Luthor2k/baudotty/scrap/alive.png

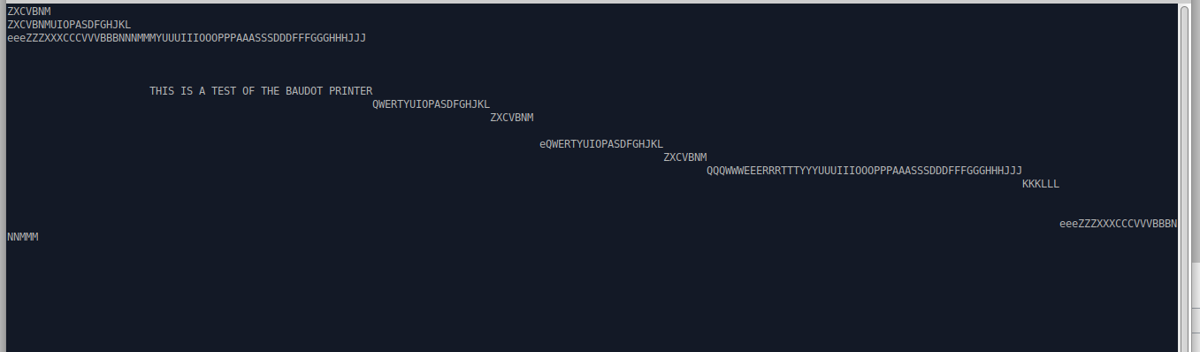
scrap/alive.png
