Luthor2k/baudotty/scrap/baudot2.png

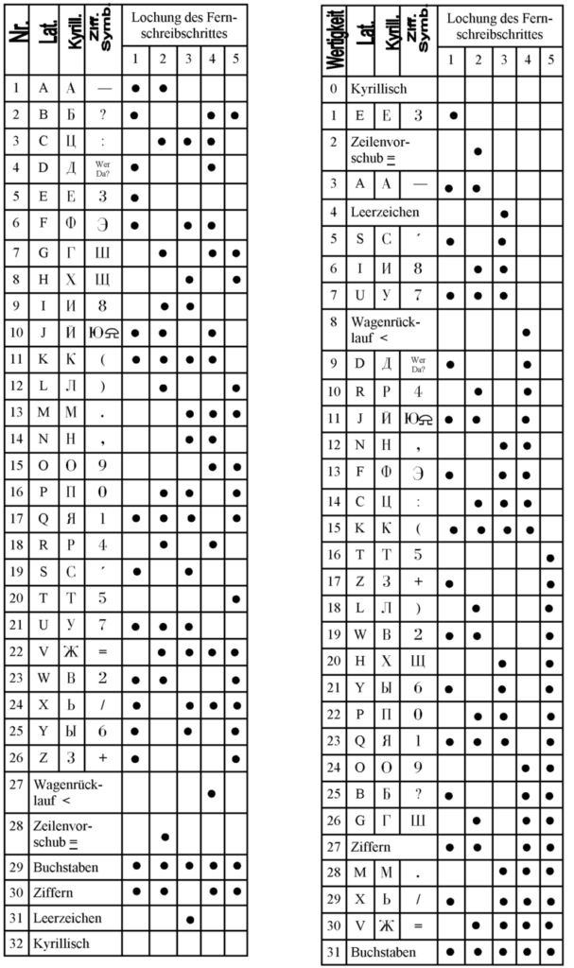
scrap/baudot2.png
