Luthor2k/baudotty/scrap/baudot3.png

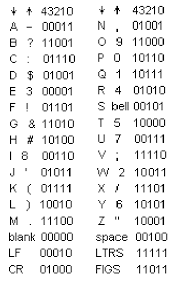
scrap/baudot3.png
