Luthor2k/baudotty/scrap/baudot4.png

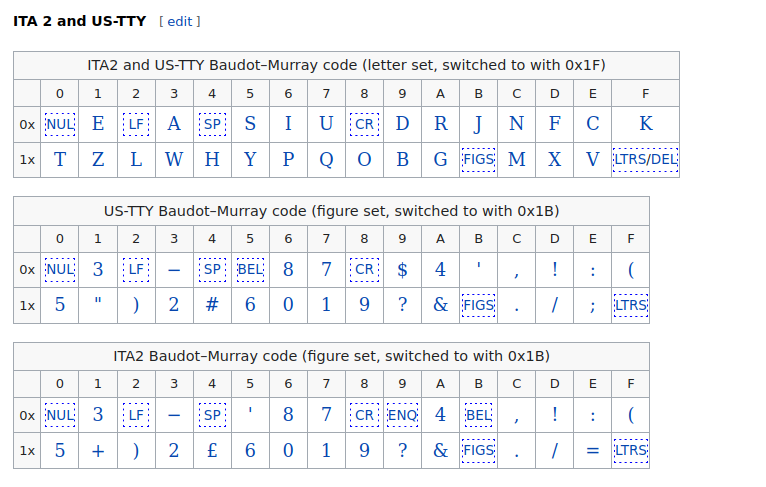
scrap/baudot4.png
