Luthor2k/baudotty/scrap/baudot-cap-and-convert.png

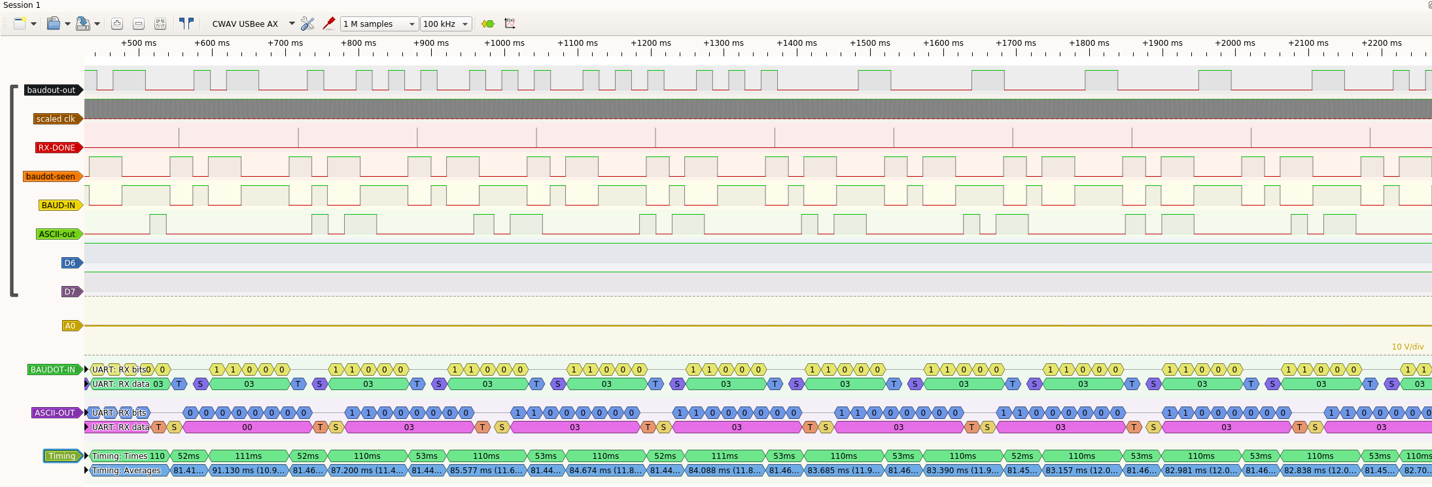
scrap/baudot-cap-and-convert.png
