Luthor2k/baudotty/scrap/baudot-coming-in.png

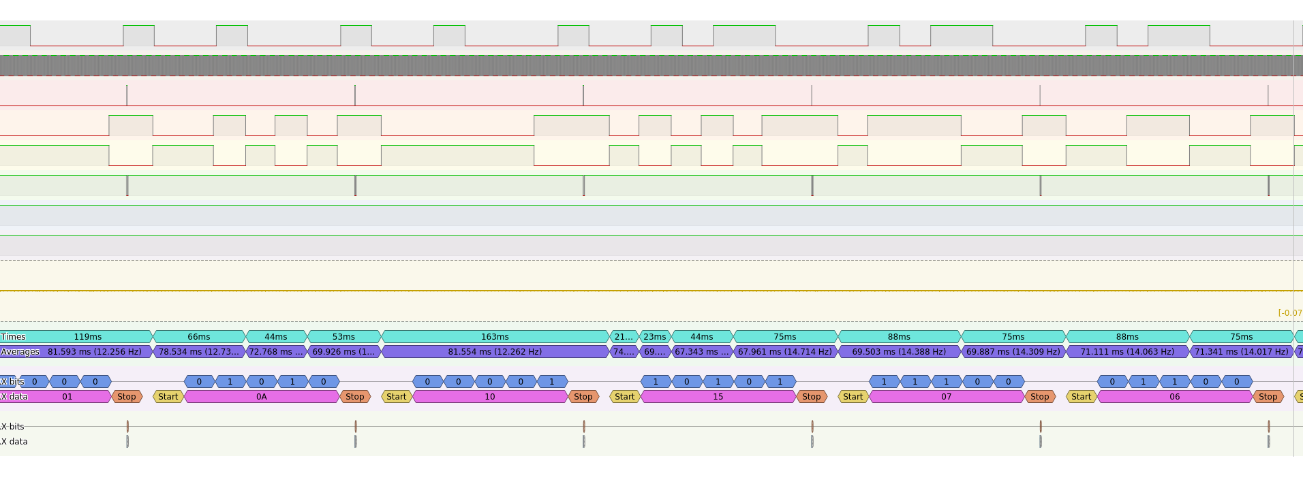
scrap/baudot-coming-in.png
