Luthor2k/baudotty/scrap/messy-baudot-to-ascii.png

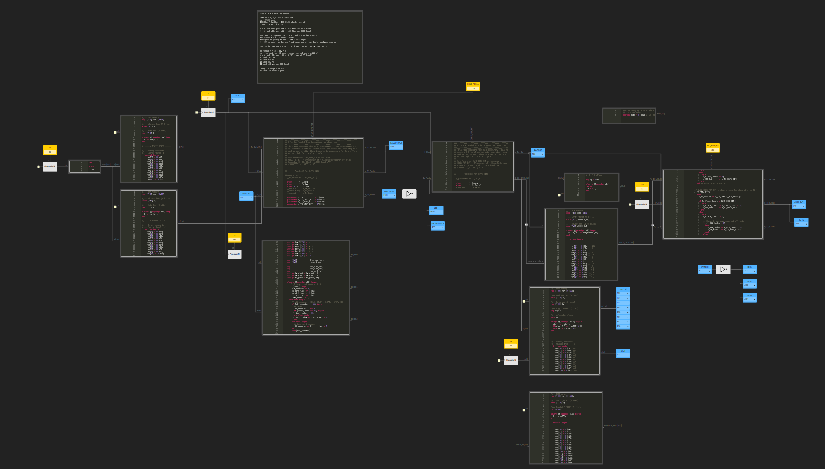
scrap/messy-baudot-to-ascii.png
