Luthor2k/baudotty/scrap/parallel-output-capture.png

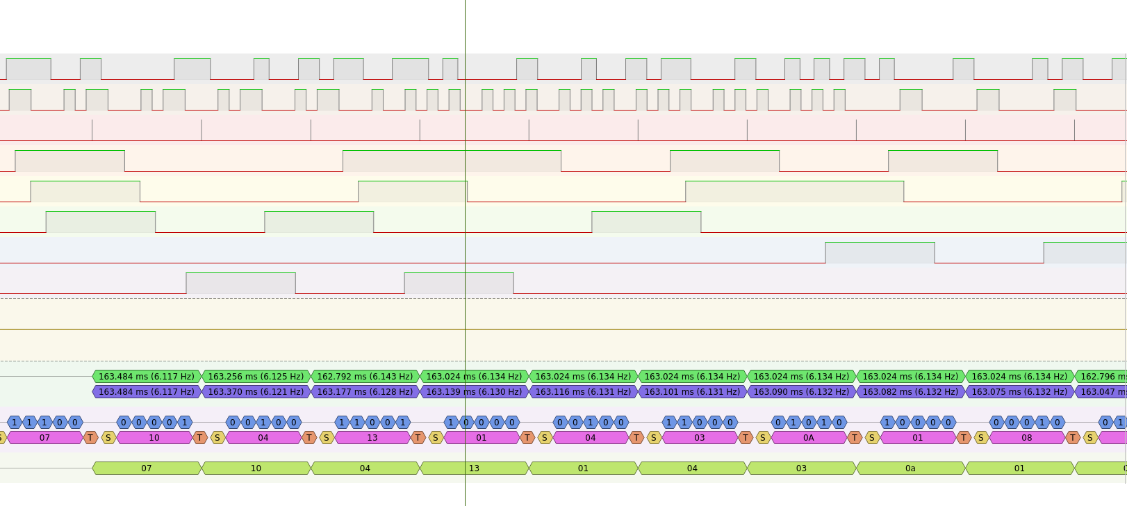
scrap/parallel-output-capture.png
