Luthor2k/baudotty/scrap/punch-tape-reader-bit-time.png

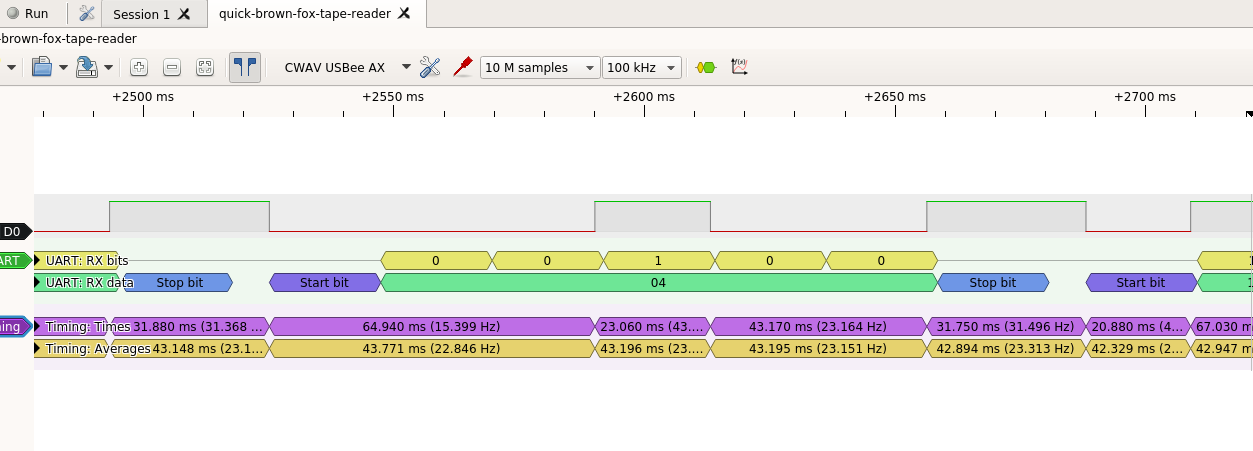
scrap/punch-tape-reader-bit-time.png
