Luthor2k/baudotty/scrap/PXL_20221128_051956458.jpg

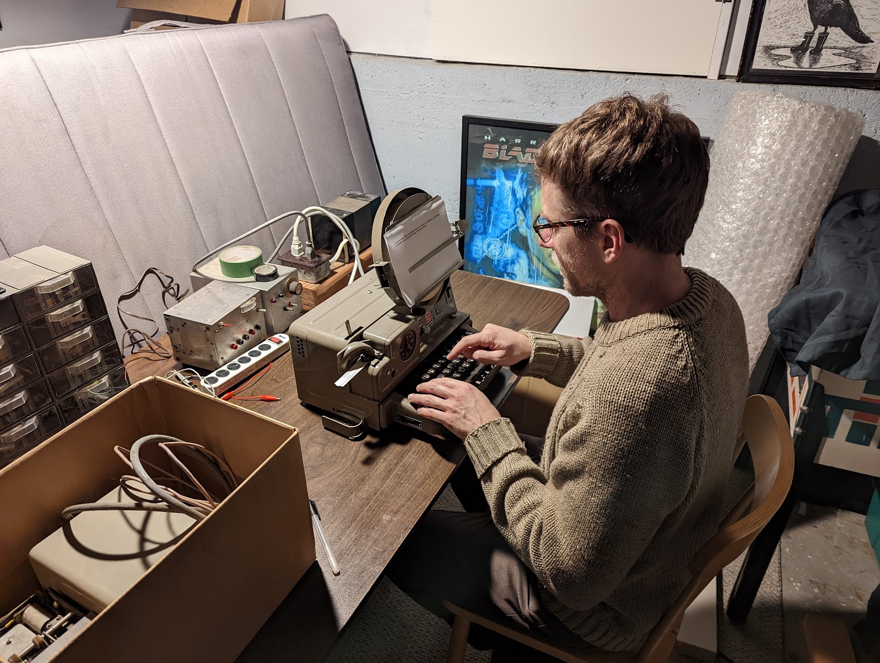
scrap/PXL_20221128_051956458.jpg
