Luthor2k/baudotty/scrap/PXL_20221201_220216192.jpg

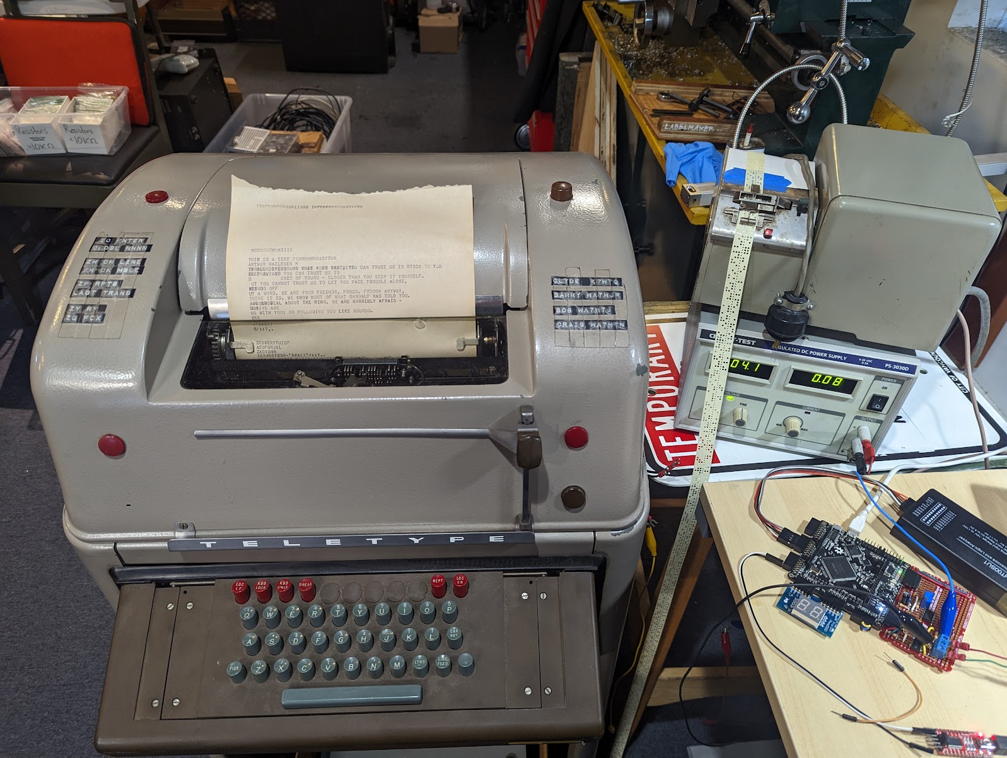
scrap/PXL_20221201_220216192.jpg
